MaxVD76/SectionControl_AgOpenGPS/Boitier (Harware)/Dessin_branchement.png

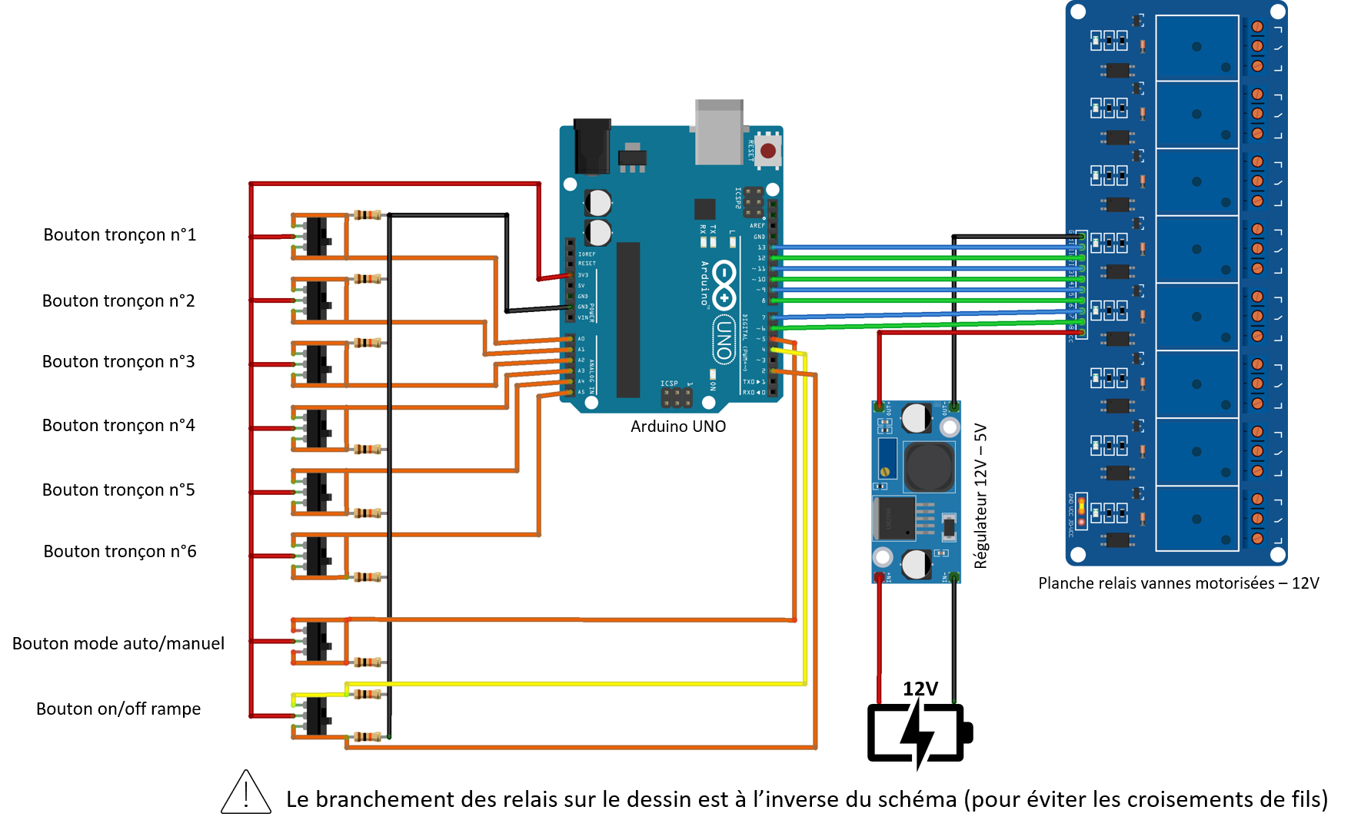
Boitier (Harware)/Dessin_branchement.png
