MaxVD76/SectionControl_AgOpenGPS/Boitier (Harware)/Schéma_branchements.png

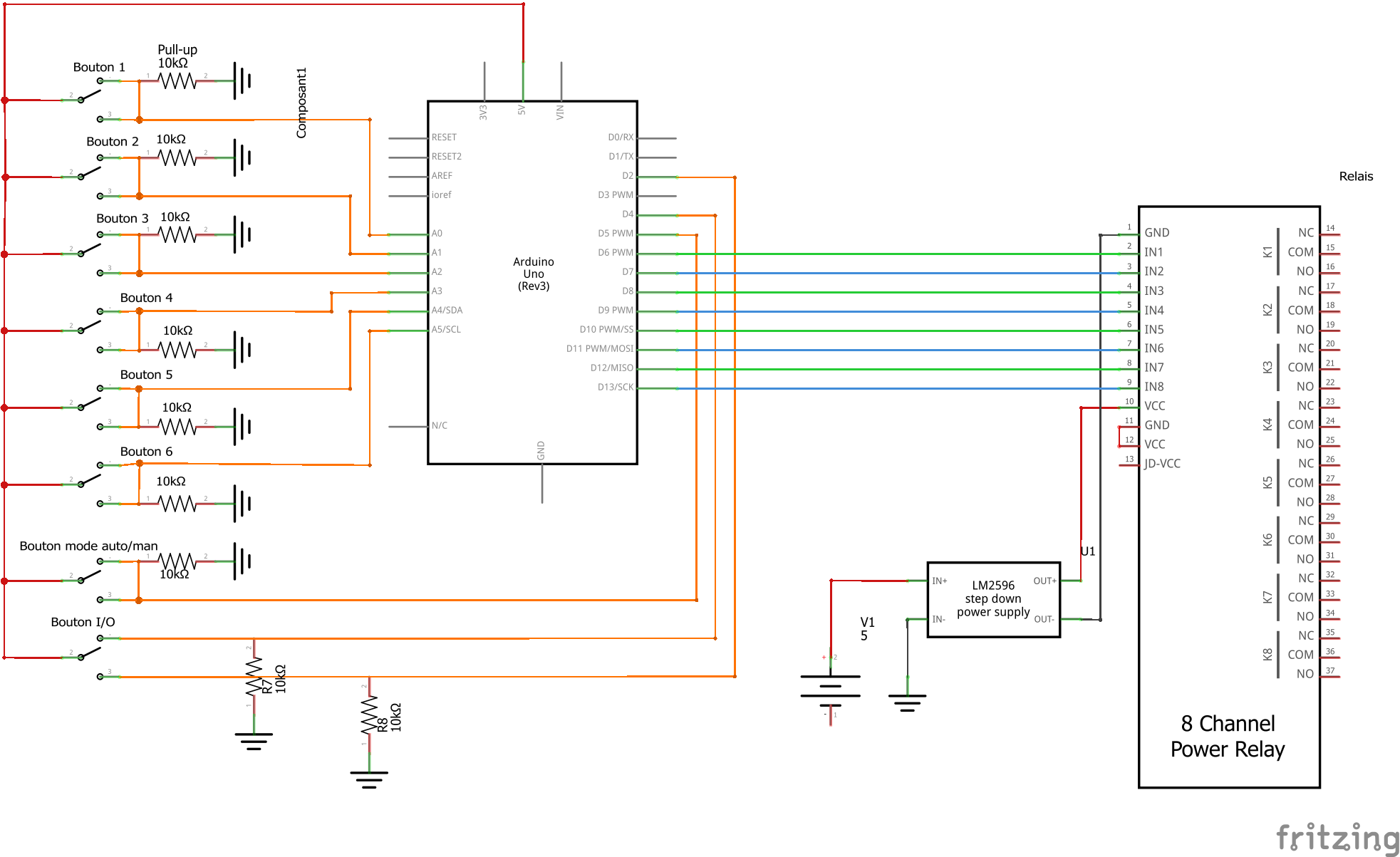
Boitier (Harware)/Schéma_branchements.png
