MaxVD76/SectionControl_AgOpenGPS/Boitier (Harware)/Parts_AOG_SC_V0.9.ods

Sheet: Hardware_-_Pièces
Coupure tronçon - Jusqu'à 7 tronçons
Maxime VIAUD |  |  | févr-21 |  | V0.9
Nombre de tronçons | 6
Matériel utilisé sur la maquette de la vidéo
Désignation | Qte | Lien | Prix Unitaire(€) | Prix tot (€)
Arduino UNO | 1 | https://www.gotronic.fr/art-carte-arduino-uno-12420.htm | 19,5 | 19,5
Modules relais (planche de 8) | 1 | https://www.gotronic.fr/art-module-8-relais-5-vcc-gt1116-28501.htm | 9,9 | 9,9
Régulateur tension 12V --> 5v | 1 | https://www.gotronic.fr/art-regulateur-ajustable-1-25-a-30-vcc-gt134-26094.htm | 2,5 | 2,5
Intérupteurs (on)-off-(on) | 8 | https://www.gotronic.fr/art-inverseur-unipolaire-8014a-4175.htm | 1,9 | 15,2
Résistance 10k ohms (pull up) | 8 | https://www.gotronic.fr/art-10-resistances-1-4w-10k-8486-19.htm |  | 0,2
Leds | 6 | https://www.gotronic.fr/art-led-5mm-bleue-l53bd-2073.htm | 0,3 | 1,8
Résistance 220 ohms (leds) | 6 | https://www.gotronic.fr/art-10-resistances-1-4w-220-8486-2568.htm |  | 0,2
Cordon USB A --> B | 1 | https://www.gotronic.fr/art-cordon-1-8-m-usb077-26239.htm | 2,3 | 2,3
Boitier électrique | 1 | https://www.castorama.fr/boite-de-derivation-exterieure-avec-10-passe-cables-et-systeme-de-verrouillage-integre-diall-150-x-110-x-70-mm/3663602794158_CAFR.prd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 | 8,4 | 8,4
Carte + Antenne GNSS | 1 | https://www.ardusimple.com/product/simplertk2b-basic-starter-kit-ip65/ | 211 | 211
+ fils
+ fer à souder
+perceuse
+ tablette windows 10
 |  |  | Total (€) | 271

Sheet: Branchements
Port arduino | Nom code | Composant
A0 | button1Pin | Int. Section 1
A1 | button2Pin | Int. Section 2
A2 | button3Pin | Int. Section 3
A3 | button4Pin | Int. Section 4
A4 | button5Pin | Int. Section 5
A5 | button6Pin | Int. Section 6
0 | - | -
1 | - | -
2 | button7Pin | Int. Section 7
3 | buttonboomonPin | Int. on/off rampe
4 | buttonboomoffPin
5 | buttonmodePin | Int. Mode auto/manuel
6 | sect1Pin | Contrôle section 1 | relais + led
7 | sect2Pin | Contrôle section 2 | relais + led
8 | sect3Pin | Contrôle section 3 | relais + led
9 | sect4Pin | Contrôle section 4 | relais + led
10 | sect5Pin | Contrôle section 5 | relais + led
11 | sect6Pin | Contrôle section 6 | relais + led
12 | sect7Pin | Non utilisé | relais + led
13 | sect8Pin | Non utilisé
